jericho-adler/ocean-harness/3D models/Ocean Harness.step

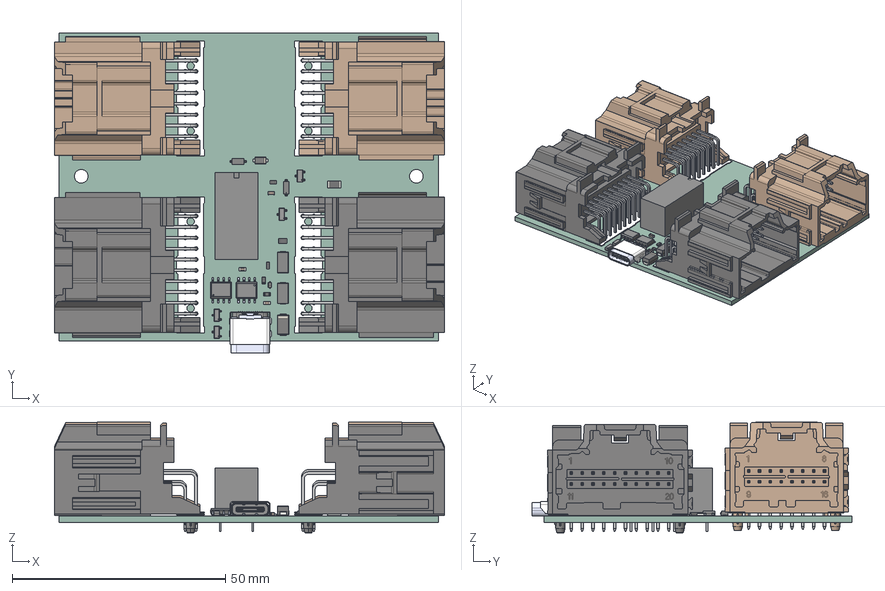
[picture p2: CAD file, 2026-11-04]
3D models/Ocean Harness.step
91.4 x 75.0 x 25.9 mm
D_SMA
C_0603_1608Metric x 3
FilletPin1 x 2
FilletPin2 x 2
R_0603_1608Metric x 4
PinsArrayL x 4
FilletPinR x 4
D_SOD_523
LF351 x 2
DX07S024XJ1R1100
Fuse_1206_3216Metric
G5V-2-DC12
R_0805_2012Metric
D_SOD_123F
Ocean Harness_PCB
