jericho-adler/ocean-harness/PCB Files/Ocean Harness.kicad_pcb

## KiCad design PCB Files/Ocean Harness.kicad_pcb (2026-11-10)

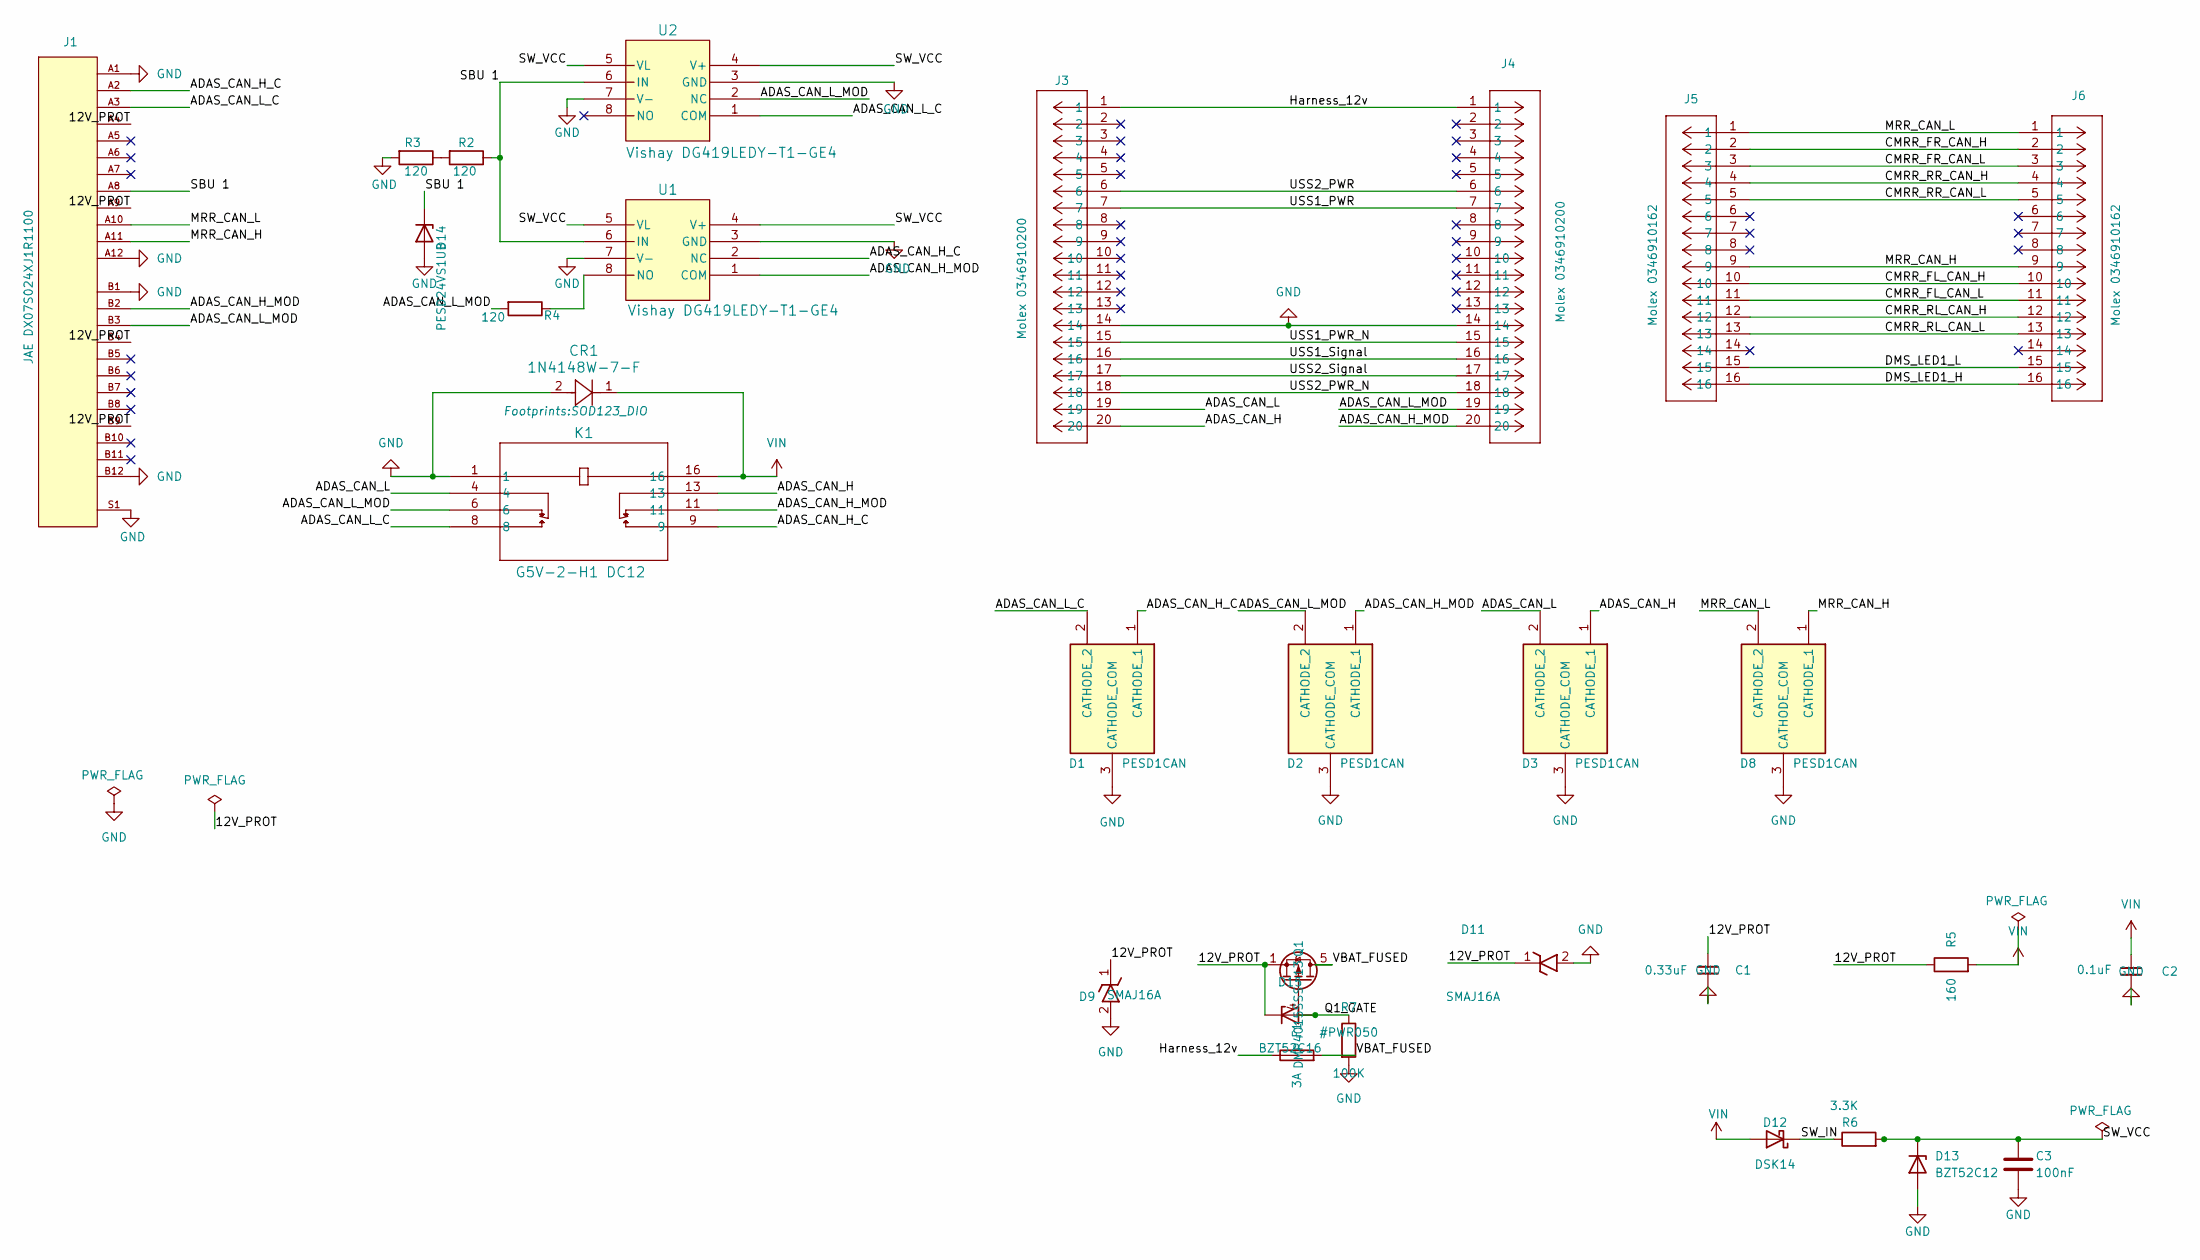
[picture p3: schematic Ocean Harness.kicad_sch]

Parts:
C1: 0.33uF; C_0603_1608Metric; Voltage 50V; MPN TCC0603X7R334K500CT; JLCPCB Part # C282682
C2: 0.1uF; C_0603_1608Metric; Voltage 50V; MPN CL10B104KB8NNNC; JLCPCB Part # C1591
C3: 100nF; C_0603_1608Metric; MPN CL10B104KB8NNNC; JLCPCB Part # C1591
CR1: 1N4148W-7-F; SOD123_DIO; MPN 1N4148W-7-F; JLCPCB Part # C83528
D1, D2, D3, D8: PESD1CAN; MPN PESD1CAN,215; JLCPCB Part # C15771
D9, D11: SMAJ16A; MPN SMAJ16A; JLCPCB Part # C74561
D12: DSK14; D_SOD-123F; MPN DSK14; JLCPCB Part # C37049
D13: BZT52C12; SOD123_DIO; MPN BZT52C12-7-F; JLCPCB Part # C124196
D14: PESD24VS1UB; D_SOD-523; MPN PESD24VS1UB,115; JLCPCB Part # C85382
D15: BZT52C16; SOD123_DIO; MPN BZT52C16-7-F; JLCPCB Part # C397929
F1: 3A; Fuse_1206_3216Metric; MPN 0685T3000-01; JLCPCB Part # C5456894
J1: JAE DX07S024XJ1R1100; MPN DX07S024XJ1R1100; JLCPCB Part # C134113
J3, J4: Molex 0346910200; CONN_SD-34691-100_20_MOL; MPN 34691-0200; JLCPCB Part # C293461
J5, J6: Molex 0346910162; CONN_SD-34691-100_16_MOL; MPN 34691-0162; JLCPCB Part # C585844
K1: G5V-2-H1 DC12; Omron G5V-2-DC12; MPN G5V-2-H1 DC12; JLCPCB Part # C128021
Q1: DMP4015SSS-13; SOIC-8_3.9x4.9mm_P1.27mm; MPN DMP4015SSS-13; JLCPCB Part # C508210
R2, R3, R4: 120; Rohm ESR03EZPJ121; MPN ESR03EZPJ121; JLCPCB Part # C2846664
R5: 160; R_0805_2012Metric; MPN FRC0805F1600TS; JLCPCB Part # C2960793
R6: 3.3K; Rohm ESR03EZPJ121; MPN ESR03EZPF3301; JLCPCB Part # C510091
R7: 100K; Rohm ESR03EZPJ104; MPN ESR03EZPJ104; JLCPCB Part # C253331
U1, U2: Vishay DG419LEDY-T1-GE4; MPN DG419LEDY-T1-GE4; JLCPCB Part # C2673265

Connections:
/12V_PROT: C1.1, D9.1, D11.1, D15.1 (K), J1.A4, J1.A9, J1.B4, J1.B9, Q1.1 (S), Q1.2 (S), Q1.3 (S), R5.1
/ADAS_CAN_H: D3.1 (CATHODE_1), J3.20, K1.13
/ADAS_CAN_H_C: D1.1 (CATHODE_1), J1.A2, K1.9, U1.2 (NC)
/ADAS_CAN_H_MOD: D2.1 (CATHODE_1), J1.B2, J4.20, K1.11, U1.1 (COM)
/ADAS_CAN_L: D3.2 (CATHODE_2), J3.19, K1.4
/ADAS_CAN_L_C: D1.2 (CATHODE_2), J1.A3, K1.8, U2.1 (COM)
/ADAS_CAN_L_MOD: D2.2 (CATHODE_2), J1.B3, J4.19, K1.6, R4.2, U2.2 (NC)
/CMRR_FL_CAN_H: J5.10, J6.10
/CMRR_FL_CAN_L: J5.11, J6.11
/CMRR_FR_CAN_H: J5.2, J6.2
/CMRR_FR_CAN_L: J5.3, J6.3
/CMRR_RL_CAN_H: J5.12, J6.12
/CMRR_RL_CAN_L: J5.13, J6.13
/CMRR_RR_CAN_H: J5.4, J6.4
/CMRR_RR_CAN_L: J5.5, J6.5
/DMS_LED1_H: J5.16, J6.16
/DMS_LED1_L: J5.15, J6.15
/Harness_12v: F1.1, J3.1, J4.1
/MRR_CAN_H: D8.1 (CATHODE_1), J1.A11, J5.9, J6.9
/MRR_CAN_L: D8.2 (CATHODE_2), J1.A10, J5.1, J6.1
/Q1_GATE: D15.2 (A), Q1.4 (G), R7.1
/SBU 1: D14.1 (K), J1.A8, R2.1, U1.6 (IN), U2.6 (IN)
/SW_IN: D12.1 (K), R6.1
/SW_VCC: C3.1, D13.1 (K), R6.2, U1.4 (V+), U1.5 (VL), U2.4 (V+), U2.5 (VL)
/USS1_PWR: J3.7, J4.7
/USS1_PWR_N: J3.15, J4.15
/USS1_Signal: J3.16, J4.16
/USS2_PWR: J3.6, J4.6
/USS2_PWR_N: J3.18, J4.18
/USS2_Signal: J3.17, J4.17
/VBAT_FUSED: F1.2, Q1.5 (D), Q1.6 (D), Q1.7 (D), Q1.8 (D)
GND: C1.2, C2.2, C3.2, CR1.2, D1.3 (CATHODE_COM), D2.3 (CATHODE_COM), D3.3 (CATHODE_COM), D8.3 (CATHODE_COM), D9.2, D11.2, D13.2 (A), D14.2 (A), J1.A1, J1.A12, J1.B1, J1.B12, J1.S1, J3.14, J4.14, K1.1, R3.2, R7.2, U1.3 (GND), U1.7 (V-), U2.3 (GND), U2.7 (V-)
unnamed: R2.2, R3.1
unnamed: R4.1, U1.8 (NO)
VIN: C2.1, CR1.1, D12.2 (A), K1.16, R5.2

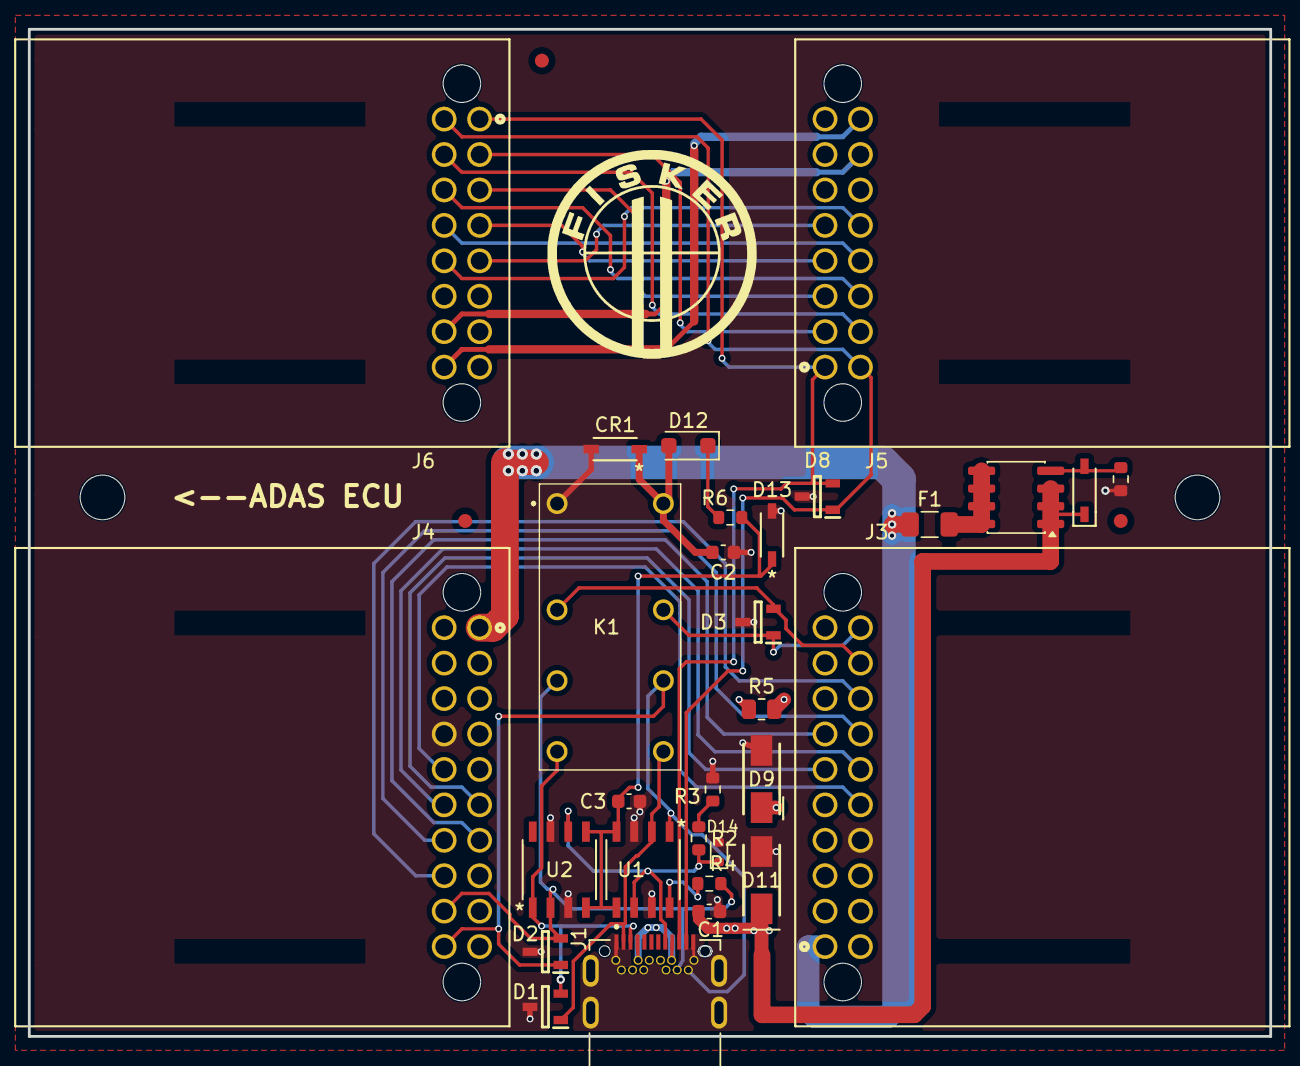
[picture p4: board Ocean Harness.kicad_pcb from above]

Board: 4 copper layers, 89.0 x 72.2 mm, 35 parts (0 on the bottom side), 35 nets.

Other parts of the board:
FID1, FID2, FID3: Fiducial_1mm_Mask2mm
H1, H2: MountingHole_3.2mm_M3
