jericho-adler/ocean-harness/(commit log)

2026-10-10 Initial commit: Ocean Harness KiCad project
    Mirrors the structure of volvo-polestar-passthrough-harness-box
    (PCB Files/, LICENSE, README) with local-only files (lib tables,
    .kicad_prl settings, editor history, logs) excluded.
    [Ocean Harness.kicad_pcb, Ocean Harness.kicad_sch]
2026-10-12 Restructure to match passthrough-harness-box repo format; update board
    Bring the repo in line with the volvo-polestar-passthrough-harness-box
    layout: a 3D models/ directory with a render and STEP export, an
    analysis/ manifest under PCB Files/, a dated design review, and a README
    that describes the board rather than stubbing it.
    Board changes made during the review, all with DRC and ERC at 0 errors:
    - K1 changed to Omron G5V-2-H1 DC12 (960 R / 12.5 mA / 150 mW coil,
    180% max coil voltage). Package-identical to the G5V-2, so the
    footprint and 3D model carry over unchanged.
    - U3 (L78L12) removed, replaced by R5 in the same footprint position.
    The part could never regulate: it needs >=14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
    [Ocean Harness.kicad_pcb, Ocean Harness.kicad_sch, Ocean Harness.step]
2026-10-12 Add R5 dropper to schematic and link its footprint on the board
    R5 (160R 0805) replaces the U3 L78L12 as the relay coil / switch supply
    dropper. The symbol was added to the schematic and the footprint had been
    hand-placed in the PCB editor, but the footprint carried no (path ...) link
    to the schematic symbol, so "Update PCB from Schematic" could not match the
    two and wanted to add a second R5.
    Linking the existing footprint (rather than letting the update drop in a new
    one) keeps its placement and its /12V_PROT and VIN traces. KiCad then filled
    in the footprint library id, description, pad pintypes and unit metadata on
    the next update, and refilled the copper zones.
    Also carried over from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
    [Ocean Harness.kicad_pcb, Ocean Harness.kicad_sch]
2026-10-12 Tie all four J1 shell pads to GND
    The JAE DX07S024XJ1R1100 symbol has a single S1 shield pin, but the footprint
    numbers its four shell solder legs S1-S4. Pads with no matching symbol pin have
    their nets cleared on "Update PCB from Schematic", so the R5 update in 0114a4f
    dropped GND from S2, S3 and S4 and left three of the four legs floating through
    both ground planes.
    Renumbering all four pads to S1 lets KiCad bind them to the one S1 pin, which
    is how shield pads are normally handled and is stable across future schematic
    updates. Pad positions, sizes, drills and uuids are unchanged.
    This was not caught by the unconnected-items check: a pad with no net cannot be
    reported as unconnected. It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
    [Ocean Harness.kicad_pcb]
2026-10-13 Fix production blockers: zone fills, fiducials, MPNs, polarity marks, via rings
    Addresses the five pre-fab blockers from design_review_2026-10-13.md. No
    track, pad, footprint position or net was modified -- net membership is
    identical across all 70 nets, all 24 original footprints have unchanged
    pad-to-net maps, and ERC is unchanged at 76 warnings / 0 errors.
    - Refill zones. As committed previously the board had stale fills, leaving
    all four J1 USB-C shield pads unconnected to the GND pour; gerbers plotted
    from it would have shipped an ungrounded shield. DRC now reports 0
    unconnected items without needing --refill-zones.
    - Add fiducials FID1-FID3 on F.Cu (standard Fiducial_1mm_Mask2m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
    [Ocean Harness.kicad_pcb, Ocean Harness.kicad_sch]
2026-10-13 README: point at the current design review
    Link the 2026-10-13 review as current and keep the 2026-10-12 one as
    superseded history, flagging the two claims in it that do not match the
    committed board.
    Also correct the footprint count, which the fiducials added in 7330a43
    made stale (24 -> 27), and reword the disclaimer: the blockers it pointed
    readers at are fixed, so it now points at the review's
    "Confirm before installing" items instead.
2026-11-02 Update board: smaller outline, dedicated switch supply rail
    Board rework, committed from the current KiCad files:
    - Outline shrunk from 115.75 x 75.25 mm to 89.0 x 72.2 mm
    - New SW_VCC rail for the DG419 analog switches, split off from the
    relay coil supply: D12 (DSK14 Schottky) blocks the dip when the coil
    pulls in, C3 holds the rail across it, and R6 + D13 (BZT52C12) clamp
    it to 12 V so the switches never see the full VBAT range
    - Rerouted: 353 segments, 57 vias; the 0.2 mm segment that was on
    12V_PROT is gone, minimum track width is now 0.25 mm
    DRC: 0 errors, 0 unconnected, 0 schematic-parity issues. The 32
    remaining warnings are cosmetic or library hygiene (silkscreen clipped
    b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
    [Ocean Harness.kicad_pcb, Ocean Harness.kicad_sch, Ocean Harness.step]
2026-11-03 Fix real ERC findings, swap D10 to MBRA340T3G, add rev 2 review
    ERC is now 0 errors; the two substantive findings are resolved.
    - COMMA_P / COMMA_N were labelled nets reaching only J1 B10/B11.
    Removed the labels and stub wires and added no-connects, matching how
    A5-A7 and B5-B8 were already handled. Renamed the two PCB pads to
    unconnected-(J1-PadB10/B11) so schematic parity stays at its
    pre-existing 9. No copper existed on either net.
    - Six local labels named VIN or GND collided with the power symbols
    (ERC reported 2 of them). All six were load-bearing - none shared a
    wire group with a power symbol - so deleting them would have orphaned
    wires. Replaced each with a power symbol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
    [Ocean Harness.kicad_pcb, Ocean Harness.kicad_sch]
2026-11-03 Close the SPICE gap in the rev 2 review
    ngspice-42 is now installed, so the simulation step the review listed as
    not performed has been run. 6 subcircuits, 6 pass / 0 warn / 0 fail /
    0 skip.
    Nothing changes the verdict or the blockers — this board has almost no
    analog content to verify. The one new piece of information is the PDN
    impedance (509 mohm at 1 MHz on 12V_PROT, 1.62 ohm on VIN), which is
    high in absolute terms but has no load on this board that would care.
    Two results are recorded with caveats: R2/R3 is detected and simulated
    as a voltage divider but its midpoint is unconnected, so it is really a
    240 ohm pulldown; and the protection-device passes use a generic diode
    model, so t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
2026-11-03 Refill zones: clears the 44 J1 hole-clearance errors
    DRC is now 0 errors, 0 unconnected, 9 schematic-parity items (the
    pre-existing 4 field-text mismatches and 5 mechanical extra_footprint).
    Nothing geometric changed. J1's pads are byte-identical - still 0.65 mm
    copper on a 0.45 mm drill - and the board still has the same 33
    footprints, 357 track segments and 64 vias. The only delta is the zone
    fills: GND on F.Cu/In1.Cu went from 11 islands / 14357 points to 9 /
    11441, GND on B.Cu from 4407 to 3700 points, VIN from 7371 to 8238, and
    12V_PROT from 504 to 413.
    That confirms the earlier diagnosis: the 44 errors were an artifact of a
    stale fill computed before F1 and D14 landed, not inherent g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
    [Ocean Harness.kicad_pcb]
2026-11-04 Regenerate board render as a proper iso shot
    Match the style of the volvo-polestar-passthrough-harness-box render:
    perspective projection, low raking camera angle, zoomed out with
    margin so the full board fits in frame, transparent background with
    floor shadow.
2026-11-04 Add Fisker logo to front silkscreen, refresh README render
    Place a vectorized Fisker badge (ring + letters + H-bars as true
    holes via earcut triangulation, not a solid blob) in the empty gap
    between J5 and J6 on F.SilkS. Zero new DRC violations.
    Re-render the README's iso shot from the current board so it reflects
    the added logo instead of the stale rev 1 layout.
    [Ocean Harness.kicad_pcb]
2026-11-04 Regenerate STEP model from the current rev 2 board
    The committed STEP was still the rev 1 geometry. Re-exported from
    PCB Files/Ocean Harness.kicad_pcb (kicad-cli pcb export step
    --subst-models), so it now matches the current layout and includes
    the Fisker silkscreen logo footprint on the board body.
    [Ocean Harness.step]
2026-11-04 Re-export STEP with silkscreen so the Fisker logo shows as geometry
    Previous STEP regen (d0ea9db) only picked up the rev 2 board shape;
    silkscreen graphics weren't included so the logo wasn't actually
    visible on the model. Re-ran with --include-silkscreen.
    [Ocean Harness.step]
2026-11-04 Drop silkscreen geometry from the STEP export
    Baking in all silkscreen graphics (not just the logo) added more
    visual clutter than wanted. Back to the plain board+components
    export (board shape still current, matches d0ea9db).
    [Ocean Harness.step]
2026-11-08 Put the P-FET reverse-polarity stage on the board
    The schematic had already swapped D10 for an ideal-diode pass element
    (Q1 DMP4015SSSQ-13, R7 gate pulldown, D15 gate clamp), but the board
    still carried D10 and none of the three new parts, so schematic and
    PCB described different circuits.
    Q1 does not fit D10's slot. The pocket between J1 and J3 is 4.50 mm
    wide (J1's pads reach x=132.28, J3's courtyard starts at 137.03) and
    a SOIC-8 needs 7.4 x 5.4 mm in either orientation; relocating D11
    does not help, since the widest channel in that cluster is 5.06 mm
    against U1. The group went into the J5-J3 gap instead, directly
    after F1 - the only free area large enough, and the better place for
    it el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
    [Ocean Harness.kicad_pcb, Ocean Harness.kicad_sch]
2026-11-08 Cut JAE's boss-2 locating slot on J1
    J1's second locating boss wants an obround slot, not a round hole.
    JAE drawing SJ116123, embedded in this board, specifies boss 1 as a
    round 0.75 hole and boss 2 as a 0.95 +/-0.05 x 0.75 +/-0.025 slot -
    the round-plus-slot scheme that absorbs the +/-0.05 boss-pitch
    tolerance. The footprint had a plain 0.775 round hole in both
    positions, which can bind on assembly.
    Added the six Edge.Cuts items, giving a 1.000 x 0.775 mm slot at
    local (7.2, 0): the same geometry the Volvo/Polestar harness box
    ships, and inside the drawing's tolerance window.
    Two consequences:
    - JAE's pattern necessarily crowds J1's own GND copper against that
    slot - pad A12 lands at 0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
    [Ocean Harness.kicad_pcb]
2026-11-08 Apply pre-fab fixes: edge clearance, In2 ground, DMS, BOM
    Fixes from the pre-fab review, added here as
    PCB Files/design_review_2026-11-08_prefab.md.
    - Copper to board edge. 1758324 relaxed min_copper_edge_clearance
    to 0.2 mm board-wide for J1's boss slot, so every pour on all four
    layers refilled out to 0.2 mm from the outline - below the 0.3 mm
    JLCPCB and PCBWay ask for. The board rule is back to 0.5 mm, and
    a new Ocean Harness.kicad_dru allows 0.2 mm only for J1's own
    outer-layer copper at the slot.
    - In2 is a ground plane instead of a VIN pour (layer typed power,
    like In1), so B.Cu signals reference ground. The 12V_PROT island
    keeps priority 1. R5's side of VIN only reached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
    [Ocean Harness.kicad_pcb, Ocean Harness.kicad_sch]
2026-11-08 Switch Q1 and C2/C3 to in-stock parts, drop CAR HARNESS label
    - Q1: DMP4015SSS-13 (C508210) instead of the AEC-Q101
    DMP4015SSSQ-13 (C531172), which LCSC/JLCPCB had no stock of. Same
    Diodes part without the automotive qualification: same pinout,
    ratings and SO-8 footprint. Datasheet link, Spec and Description
    updated to match.
    - C2, C3: Samsung CL10B104KB8NNNC (C1591), a JLCPCB Basic part, in
    place of C14663, which JLCPCB showed as unavailable. Same 100 nF
    50 V X7R 0603.
    - Board: "CAR HARNESS-->" silkscreen text removed (edited in KiCad).
    - README, OVERVIEW and the pre-fab review updated to match.
    DRC: 0 errors, 0 unconnected items, 8 parity items (unchanged).
    ERC: 0 errors.
    Co-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
    [Ocean Harness.kicad_pcb, Ocean Harness.kicad_sch]
2026-11-10 Mark D15's cathode on the silkscreen
    The board's copy of SOD123_DIO carried its pin-1 marker on F.Fab only,
    so nothing on the printed board showed which end of D15 is the cathode.
    Close the silk outline with a bar on the pad-1 (cathode, 12V_PROT) end,
    0.19 mm clear of the pad.
    DRC: 0 errors, 0 unconnected items, 8 parity items, 43 warnings (all
    unchanged).
    [Ocean Harness.kicad_pcb]
